120m4n/ikoka-stick-meshtastic-device/ikoka-stick-meshtastic-device.kicad_pcb

## KiCad design ikoka-stick-meshtastic-device.kicad_pcb (2026-10-28)

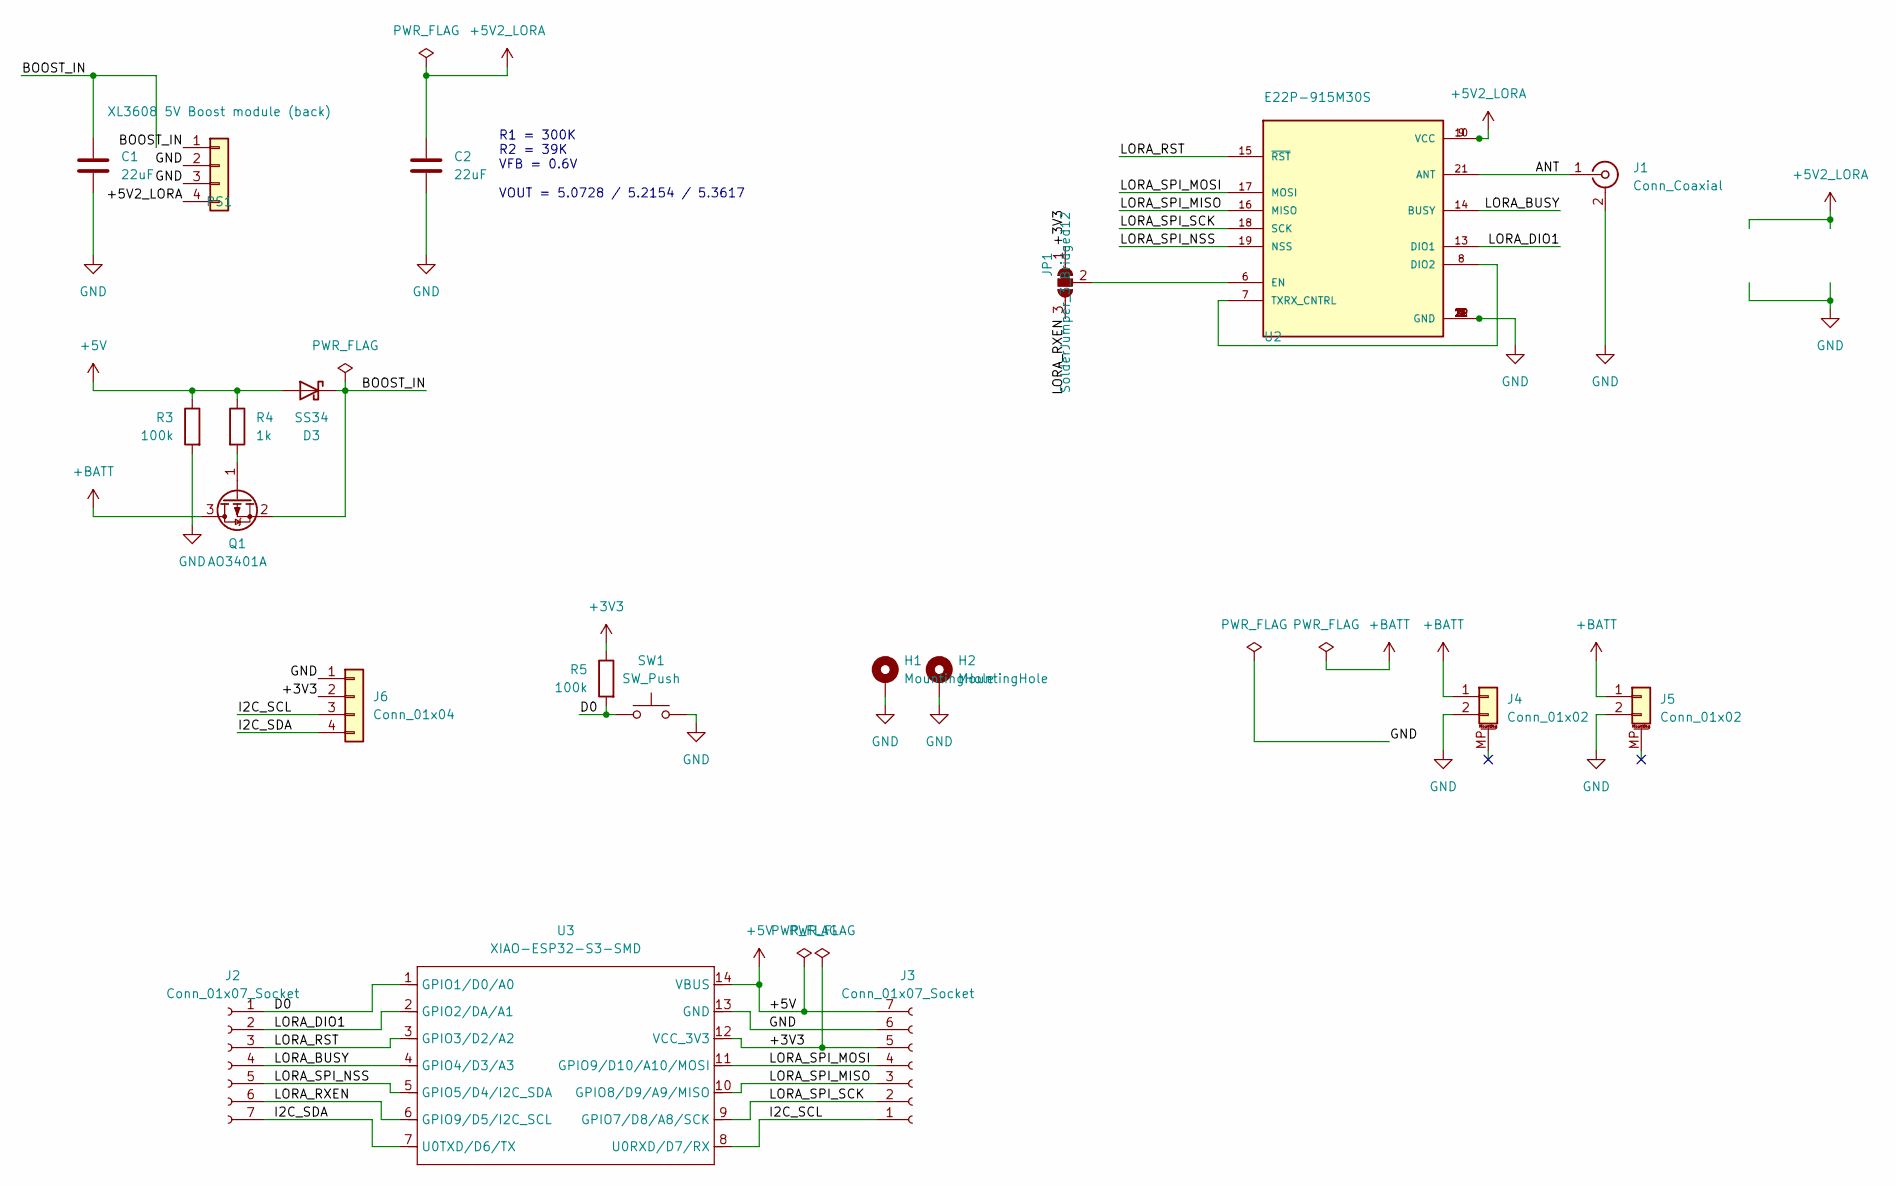
[picture p1: schematic ikoka-stick-meshtastic-device.kicad_sch]

Parts:
C1, C2: 22uF; C_0603_1608Metric; LCSC C59461
D3: SS34; D_SMA; LCSC C8678
H1, H2: MountingHole; MountingHole_2.2mm_M2_Pad_Via
J1: Conn_Coaxial; SMA_Samtec_SMA-J-P-H-ST-EM1_EdgeMount; LCSC C5250058
J2, J3: Conn_01x07_Socket; PinSocket_1x07_P2.54mm_Vertical_SMD_Pin1Left; LCSC C42379199
J4, J5: Conn_01x02; Molex_PicoBlade_53261-0271_1x02-1MP_P1.25mm_Horizontal; LCSC C2905009
J6: Conn_01x04; PinSocket_1x04_P2.54mm_Vertical_SMD_Pin1Right; LCSC C46635840
JP1: SolderJumper_3_Bridged12; SolderJumper-3_P1.3mm_Bridged12_RoundedPad1.0x1.5mm_NumberL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
PS1: XL3608 5V Boost module (back); Booster_XL3608_24.4x13.7mm_SMD
Q1: AO3401A; SOT-23; LCSC C15127
R3, R5: 100k; R_0603_1608Metric; LCSC C25803
R4: 1k; R_0603_1608Metric; LCSC C21190
SW1: SW_Push; SW_Push_1P1T_XKB_TS-1187A; LCSC C318884
U2: E22P-915M30S; XCVR_E22-900M30S; PARTREV 1.2; LCSC C51912672
U3: XIAO-ESP32-S3-SMD; XIAO-ESP32S3-DIP; LCSC C9900124959

Connections:
+3V3: J3.5, J6.2, JP1.1 (A), R5.1, U3.12 (VCC_3V3)
+5V: D3.2 (A), J3.7, R3.1, R4.1, U3.14 (VBUS)
+5V2_LORA: C2.1, PS1.4, U2.9 (VCC), U2.10 (VCC)
+BATT: J4.1, J5.1, Q1.3 (D)
/ANT: J1.1 (In), U2.21 (ANT)
/BOOST_IN: C1.1, D3.1 (K), PS1.1, Q1.2 (S)
/D0: J2.1, R5.2, SW1.1, U3.1 (GPIO1/D0/A0)
/I2C_SCL: J3.1, J6.3, U3.8 (U0RXD/D7/RX)
/I2C_SDA: J2.7, J6.4, U3.7 (U0TXD/D6/TX)
/LORA_BUSY: J2.4, U2.14 (BUSY), U3.4 (GPIO4/D3/A3)
/LORA_DIO1: J2.2, U2.13 (DIO1), U3.2 (GPIO2/DA/A1)
/LORA_RST: J2.3, U2.15 (~RST), U3.3 (GPIO3/D2/A2)
/LORA_RXEN: J2.6, JP1.3 (B), U3.6 (GPIO9/D5/I2C_SCL)
/LORA_SPI_MISO: J3.3, U2.16 (MISO), U3.10 (GPIO8/D9/A9/MISO)
/LORA_SPI_MOSI: J3.4, U2.17 (MOSI), U3.11 (GPIO9/D10/A10/MOSI)
/LORA_SPI_NSS: J2.5, U2.19 (NSS), U3.5 (GPIO5/D4/I2C_SDA)
/LORA_SPI_SCK: J3.2, U2.18 (SCK), U3.9 (GPIO7/D8/A8/SCK)
GND: C1.2, C2.2, H1.1 (1_1), H2.1 (1_1), J1.2 (Ext), J3.6, J4.2, J5.2, J6.1, PS1.2, PS1.3, R3.2, SW1.2, U2.1 (GND), U2.2 (GND), U2.3 (GND), U2.4 (GND), U2.5 (GND), U2.11 (GND), U2.12 (GND), U2.20 (GND), U2.22 (GND), U3.13 (GND)
unnamed: JP1.2 (C), U2.6 (RXEN)
unnamed: Q1.1 (G), R4.2
unnamed: U2.7 (TXEN), U2.8 (DIO2)

Notes on the sheet:
R1 = 300K R2 = 39K VFB = 0.6V VOUT = 5.0728 / 5.2154 / 5.3617

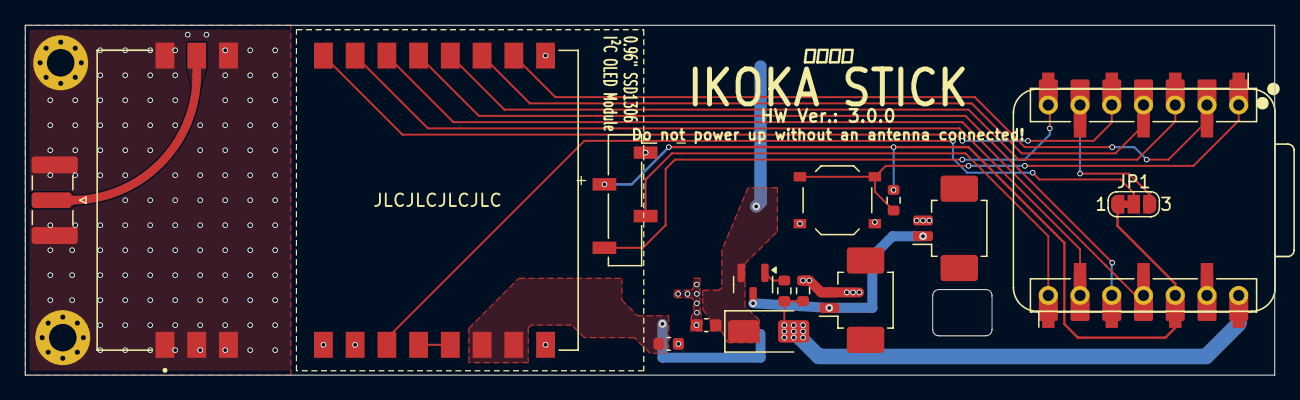
[picture p2: board ikoka-stick-meshtastic-device.kicad_pcb from above]

Board: 2 copper layers, 100.0 x 28.0 mm, 20 parts (1 on the bottom side), 21 nets.
