120m4n/ikoka-stick-meshtastic-device/(commit log)

2026-10-27 feat: Replace MT3608 boost with XL3608 commercial module footprint
    Remove U1, L1, D1, R1, R2, C3, C4 and add PS1 (4 solder pads, assumed
    24.4x13.7mm + 10% margin, to be updated with caliper measurements).
    Schematic also saved in KiCad 10 format.
    [ikoka-stick-meshtastic-device.kicad_sch]
2026-10-27 chore: Add J2/J3 PinSocket_1x07 rotation rule and CLAUDE.md
    [rotations.csv]
2026-10-27 fix: Route PS1, sync PCB nets from schematic and clean up DRC
    - Update J3.5, J6.3, J6.4 pad nets to match schematic (+3V3, /I2C_SCL, /I2C_SDA)
    - Rotate PS1 header 180 deg in place so BOOST_IN lands in its pour; route
    PS1.4 to the +5V2_LORA pour with a 0.6 mm F.Cu track
    - Remove leftover no-net zone and orphan GND vias from the old booster; refill zones
    - Include PS1 in BOM to match the symbol
    - Use ${KIPRJMOD} for the Booster_Module footprint library path
    - PCB and project saved in KiCad 10 format
    DRC: 0 errors, 0 unconnected, 0 parity issues.
    [ikoka-stick-meshtastic-device.kicad_pcb, ikoka-stick-meshtastic-device.kicad_sch]
2026-10-28 feat: v2 - drop 21700 battery, mount XL3608 module on the back
    - Remove BT1 (21700 holder) and its B.Cu +BATT pours/vias; trim the F.Cu
    +BATT strip to J5. Board is powered from the XIAO USB 5V.
    - Keep D3 (VBUS backfeed block), C1, and the Q1/R3/R4 power path with
    J4/J5 for an optional LiPo; rejoin Q1-J4-J5 with a back track.
    - New footprint Booster_XL3608_24.4x13.7mm_SMD (SMD pads only, assumed
    positions, VIN/VOUT/GND silk labels). PS1 placed on B.Cu, vertical, under
    the old header spot, clear of the E22 RF area. Only its own pads are
    exposed under the module (vias tented).
    - Silkscreen HW Ver. 2.0.0; README power section updated.
    Co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
    [ikoka-stick-meshtastic-device.kicad_pcb, ikoka-stick-meshtastic-device.kicad_sch]
2026-10-28 feat: v2 - add VIN to VOUT orientation arrow on XL3608 silkscreen
    Claude-Session: https://claude.ai/code/session_013aihWTyEvMfq2tmgNbS7qs
    [ikoka-stick-meshtastic-device.kicad_pcb]
2026-10-28 feat: v3 - use E22P LoRa module (EN jumper JP1), ported from tahnok fork
    E22P pin 6 is EN (must be high) instead of RXEN: route it to solder
    jumper JP1 under the XIAO, bridged to 3V3 by default, D6 optional.
    Pin 7 (T/R CTRL) stays on DIO2. Symbol and routing from
    tahnok/ikoka-stick-meshtastic-device 366648b.
    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
    [ikoka-stick-meshtastic-device.kicad_pcb, ikoka-stick-meshtastic-device.kicad_sch]
2026-10-28 docs: v3 - JP1 configuration table and firmware notes
    RXEN/EN select is XIAO pin 6 (D5), not D6.
    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
2026-10-28 feat: v3 - swap OLED header J6 power pins (GND first), ported from tahnok fork
    J6 pin 1 = GND, pin 2 = +3V3 as in tahnok 366648b; silk +/- marks.
    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
    [ikoka-stick-meshtastic-device.kicad_pcb, ikoka-stick-meshtastic-device.kicad_sch]
2026-10-28 fix: JLCPCB PCBA rotation of pin sockets J2/J3/J6 with Fabrication Toolkit
    Fabrication Toolkit ignores jlcpcb/rotations.csv; add hidden
    "FT Rotation Offset" = 90 to J2, J3, J6 (positions: J2 0, J3 180, J6 90).
    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
    [ikoka-stick-meshtastic-device.kicad_pcb, ikoka-stick-meshtastic-device.kicad_sch]
2026-10-28 fix: U2 JLCPCB part to E22P-915M30S (C51912672)
    U2 still carried the E22-900M30S LCSC code C411294.
    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
    [ikoka-stick-meshtastic-device.kicad_pcb, ikoka-stick-meshtastic-device.kicad_sch]
